WOAH-KAMRAN/AerialLab/rev4/hardware.md

# Rev 4 hardware list

All screws are M3 socket-head unless noted. Every screw into a printed part has a captive M3 hex nut in a hex pocket, so push the nut in before you fit the part. Lengths assume 1.0 mm sides, a 1.5 mm bottom, a 2 mm printed middle deck and a 1.0 mm upper deck.

## Airframe

| Where | Qty | Screw | Nut |
|---|---:|---|---|
| Side plates into nose frame, 4 frames and rear bulkhead (19 per side) | 38 | M3×10 | captive hex |
| Side plates into spar blocks (4 per side) | 8 | M3×12 | captive hex |
| Bottom plate up into nose frame, frames and bulkhead | 12 | M3×12 | captive hex |
| Middle deck (printed) down into the 4 frames | 8 | M3×12 | captive hex |
| Middle deck (printed) down into the nose frame | 2 | M3×10 | captive hex |
| Upper deck down into nose frame, frames and bulkhead | 12 | M3×10 | captive hex |
| Upper deck up into spar blocks | 4 | M3×10 | captive hex |
| Boom pins, through the upper deck and the boom (frame x = 296 and bulkhead) | 2 | M3×35 | captive hex |
| Joiner lock screws on top of the spar blocks (self-tap into PLA) | 2 | M3×8 | none |
| Battery tray to bottom plate | 4 | M3×10 countersunk | nyloc |
| Tail mount boom clamp | 2 | M3×20 | nyloc |
| H-stab to tail mount | 4 | M3×16 (nylon is fine) | nyloc |
| Motor to nose frame | 4 | M3×10, but check that it can't reach the windings | none |
| Camera mount to upper deck | 2 | M3×8 | nyloc |

## Landing gear (pick one)

| Option | Qty | Screw | Nut |
|---|---:|---|---|
| Trike: nose gear block to bottom plate | 4 | M3×12 | captive hex |
| Trike: nose leg lock screw (self-tap) | 1 | M3×20 | none |
| Trike or taildragger: main gear block to bottom plate | 4 | M3×12 | captive hex |
| Trike or taildragger: bow gear to main block | 2 | M3×12 | captive hex |

## Totals (with trike gear)

| Item | Qty |
|---|---:|
| M3×8 | 4 |
| M3×10 | 60 |
| M3×10 countersunk | 4 |
| M3×12 | 38 |
| M3×16 | 4 |
| M3×20 | 3 |
| M3×35 | 2 |
| **Screws total** | **115** |
| M3 hex nuts (captive) | 96 |
| M3 nyloc nuts | 12 |

For taildragger, drop 4 M3×12, 1 M3×20 and 4 hex nuts (the trike nose gear). Buy about 10% spares.

Flight electronics are not included above:
- FC: 4 M3, which self-tap into the printed standoffs.
- Pi Zero 2: 4 M2.5, which self-tap into its standoffs.
- VTX: 4 M2 or M3.
- GPS and antenna: M3 or zip ties.

## Tubes

| Item | Size | Length |
|---|---|---|
| Boom | 20 mm OD × 18 mm ID CF tube | 502 mm (cut from 1 m) |
| Front spar joiner | 8 mm OD × 6 mm ID CF tube | 400 mm |
| Rear spar joiner | 8 mm OD × 6 mm ID CF tube | 216 mm |
