WOAH-KAMRAN/AerialLab/rev4/sizing_report.md

# Sizing report (generated by sizing.py)

All x stations are mm aft of the side plate front edge. Estimates, so weigh the real parts.

## Wing

| item | value |
|---|---|
| span | 1200 mm |
| chord (rectangular) | 176 mm |
| area | 0.211 m² (21.1 dm²) |
| aspect ratio | 6.8 |
| airfoil | NACA 4412, 12% thick (21 mm) |
| incidence | 0.0° to the deck line |
| leading edge at root | x = 150 |
| front spar (25% chord) | x = 194, z = 100, 8 mm tube |
| rear spar (65% chord) | x = 264, z = 100, 8 mm tube |
| panel span each side | 567 mm (fuselage is 66 wide) |
| ailerons | outer 45% of each panel, 25% chord (44 mm) |

## Tail

| item | value |
|---|---|
| tail arm (wing AC to tail AC) | 480 mm |
| H-stab: Vh 0.45 | 348 cm², 360 x 97 mm, elevator 40 mm |
| fin: Vv 0.035 | 185 cm², root 155, tip 88, height 152, rudder 50 mm |
| H-stab leading edge | x = 650 |
| boom | 20x18 CF tube, x = 250 to 752 (502 mm long, cut from 1000) |
| boom held by | frame at x = 296 and rear bulkhead at x = 335 |

## Weight and balance

CG target: **x = 198 mm** (27% chord, 48 mm behind the wing leading edge). First flights anywhere from 25 to 30% (x = 194 to 203).

### Tractor

| item | g | x |
|---|---:|---:|
| Side plates x2 (CF 1.0) | 127 | 170 |
| Bottom plate (CF 1.5) | 52 | 170 |
| Upper deck (CF 1.0) | 29 | 170 |
| Middle deck, printed 2 mm, 2 halves | 31 | 170 |
| Printed nose frame, 4 frames, rear bulkhead, spar blocks | 145 | 191 |
| M3 hardware + nuts | 40 | 170 |
| Boom 20x18, 502 mm | 46 | 501 |
| Tail surfaces (6 mm Depron) + tail mount | 29 | 674 |
| Wing panels (foam, sleeves, 2 servos, covering) | 192 | 220 |
| Joiners: 8x6x400 + 8x6x216 | 21 | 220 |
| Elevator + rudder servos (9 g, middle bay) + pushrods | 33 | 150 |
| ESC 30-40 A (middle deck, nose) | 30 | 55 |
| Pi Zero 2 W + camera cable | 15 | 116 |
| Flight controller | 10 | 185 |
| Receiver | 6 | 215 |
| FPV camera + VTX + antenna | 30 | 50 |
| GPS | 15 | 105 |
| Nose cover (Depron/coro) | 20 | 45 |
| Wiring, connectors, velcro | 40 | 170 |
| Battery 3S 2200 mAh + tray | 195 | 242 |
| Motor 2826 1400 kv + prop adapter | 60 | -18 |
| Prop 8in | 12 | -45 |
| **AUW** | **1179** | CG 198 |

Battery centre for balance: **x = 242 mm** (a 105 mm pack spans 190 to 294). Fits in the lower bay. The battery tray station for this layout is x = 242; slide the pack on the tray to fine-tune.

## Performance (tractor AUW)

| item | value |
|---|---|
| wing loading | 55.8 g/dm² |
| stall speed (CLmax 1.0) | 9.5 m/s |
| stall speed (CLmax 1.2) | 8.6 m/s |
| cruise at CL 0.45 | 14.1 m/s (51 km/h) |
| Reynolds number at cruise | 165 k |
| cruise power, L/D 8, 45% propulsive eff. | 45 W, 4.1 A |
| flight time, 2200 mAh to 80% | about 26 min cruising |

## Motor + prop, static, 3S

Model: 2826 1400 kv, Rm 0.09 Ω, I0 1.2 A, 3S at 11.1 V under load. Ct/Cp are typical static values for APC-E style props.

| prop | rpm | thrust g | current A | power W | thrust/weight | pitch speed m/s |
|---|---:|---:|---:|---:|---:|---:|
| 8x4 | 12281 | 936 | 18.6 | 195 | 0.79 | 20.8 |
| 8x5 | 11828 | 910 | 21.2 | 220 | 0.77 | 25.0 |
| 8x6 | 11320 | 872 | 24.1 | 247 | 0.74 | 28.8 |
