WOAH-KAMRAN/AerialLab/rev4/stencils/plates_A4_stencil.pdf

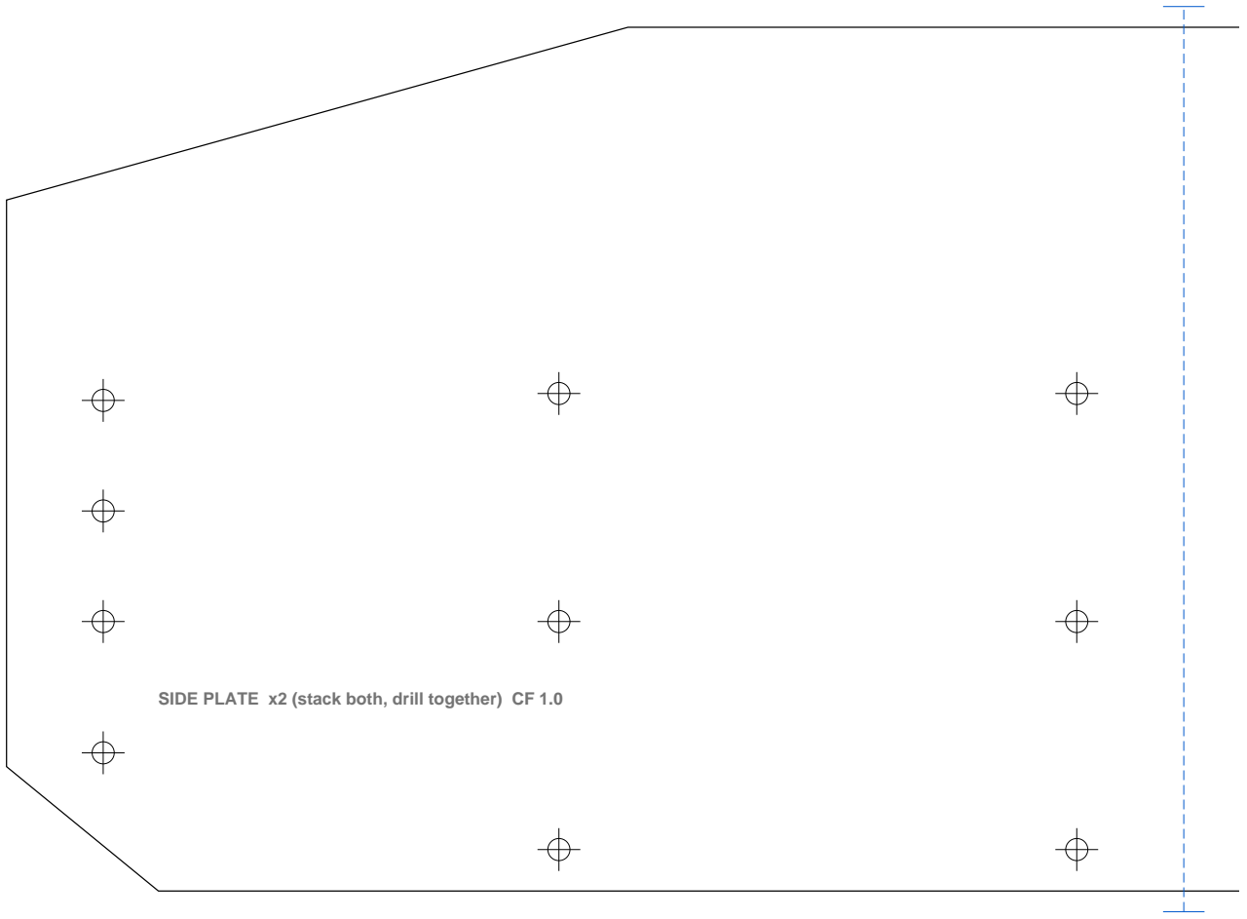
[picture p1: figure]

### SIDE PLATE x2 (stack both, drill together) CF 1.0

JOIN: trim page 1 here, lay it over page 2

## CF wing rev 4 (1.2 m) plate stencil, 1:1 page 1 of 4 (side_plate, front half)

Black circles M3 (3.2 mm), red circles spar holes. Centre-punch at each cross. Nose is on the left.

100 mm: measure this. If it is not exactly 100, reprint at 100 % / Actual size

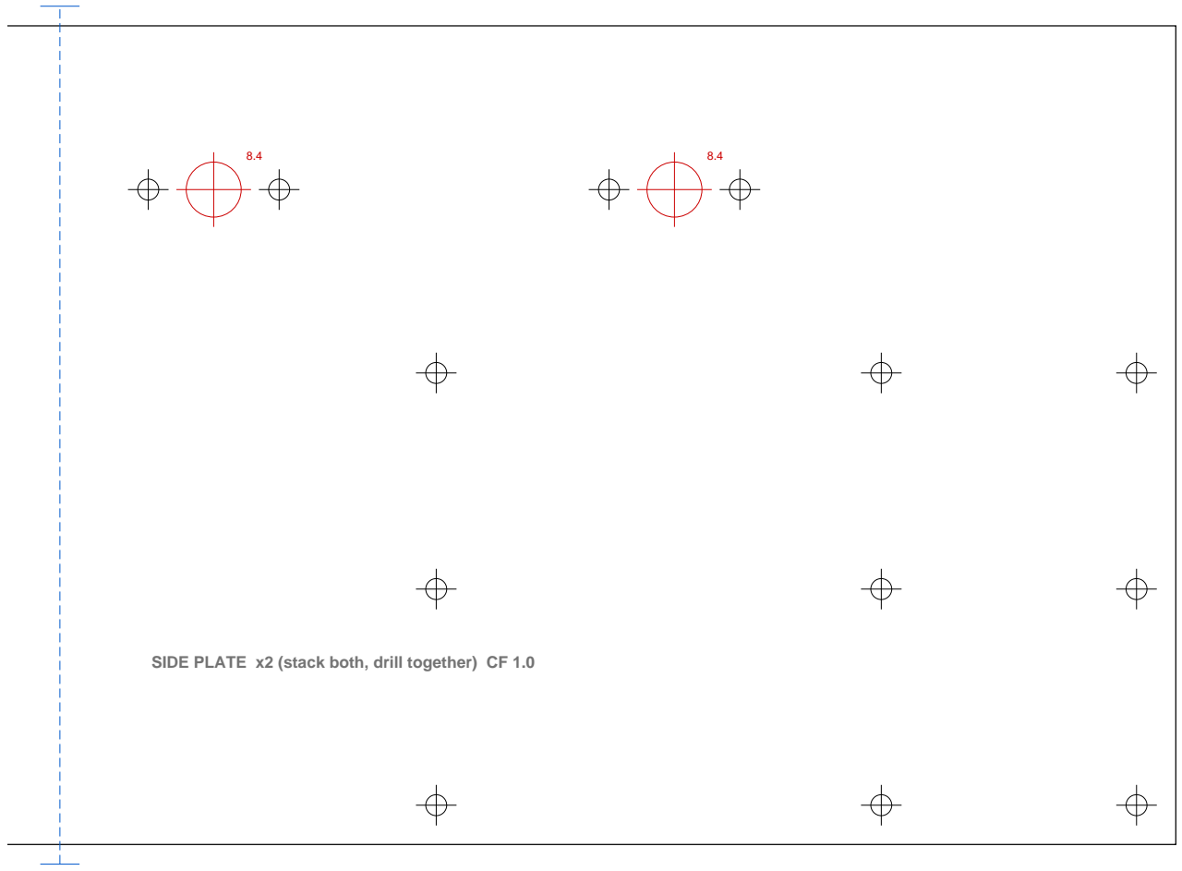
[picture p2: figure]

### SIDE PLATE x2 (stack both, drill together) CF 1.0

JOIN: trim page 1 here, lay it over page 2

## CF wing rev 4 (1.2 m) plate stencil, 1:1 page 2 of 4 (side_plate, rear half)

Black circles M3 (3.2 mm), red circles spar holes. Centre-punch at each cross. Nose is on the left, off this page.

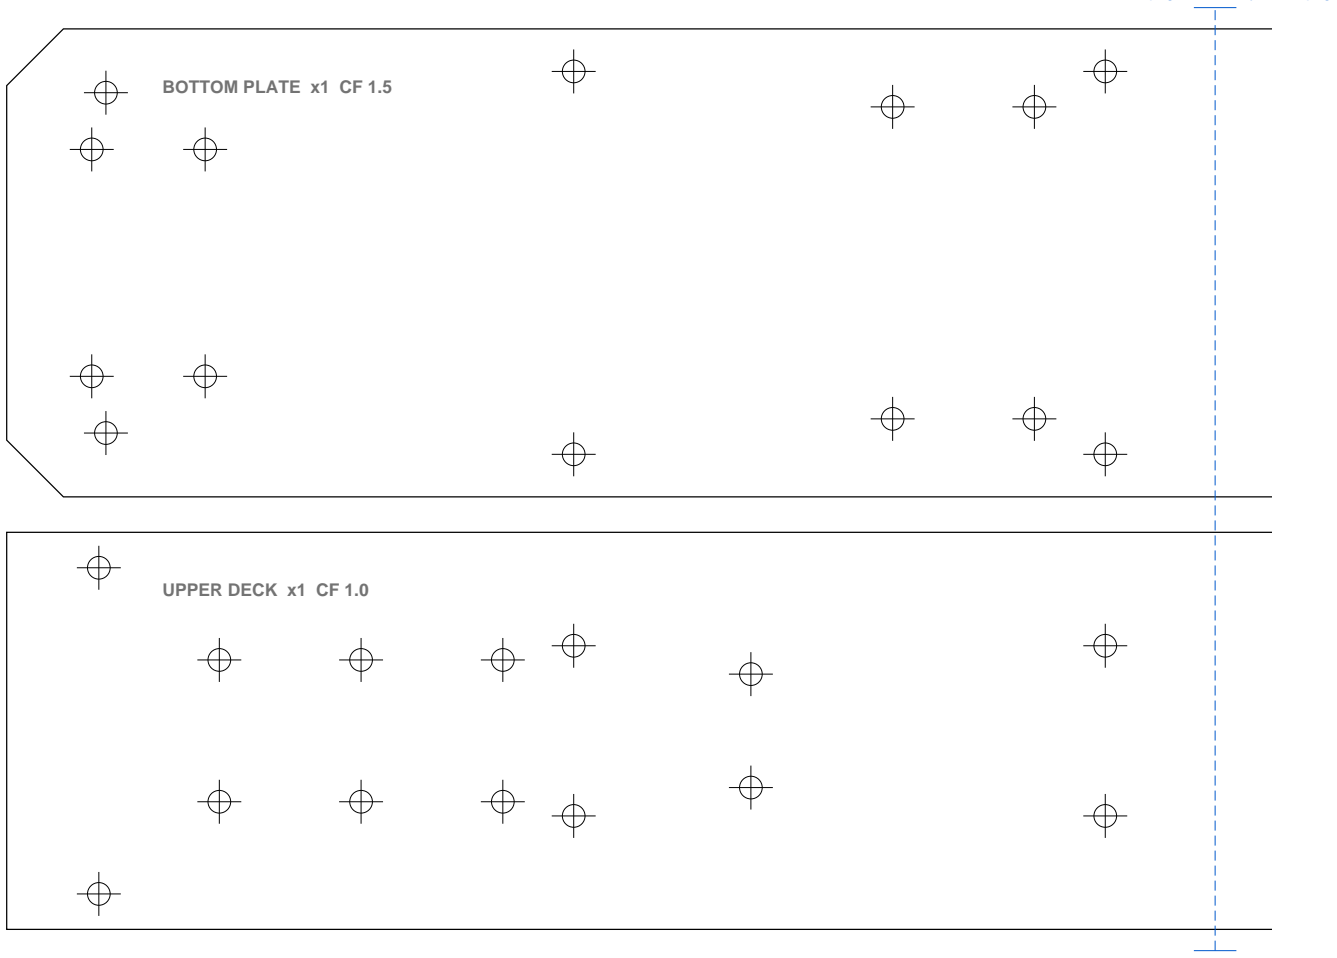
[picture p3: figure]
BOTTOM PLATE x1 CF 1.5; UPPER DECK x1 CF 1.0

JOIN: trim page 3 here, lay it over page 4

CF wing rev 4 (1.2 m) plate stencil, 1:1 page 3 of 4 (bottom_plate + upper_deck, front half)

Black circles M3 (3.2 mm), red circles spar holes. Centre-punch at each cross. Nose is on the left.

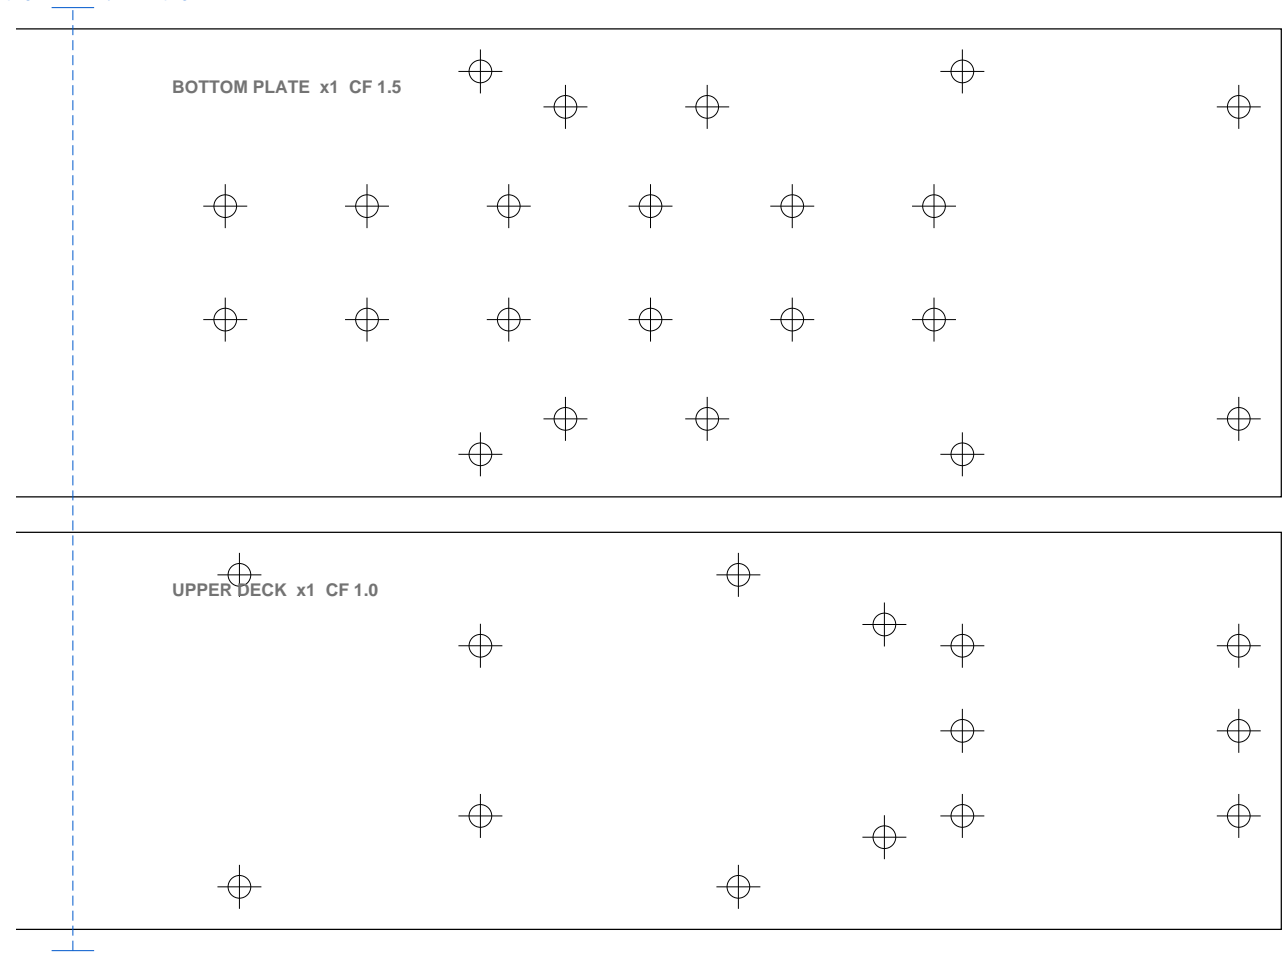
[picture p4: figure]
BOTTOM PLATE x1 CF 1.5; UPPER DECK x1 CF 1.0

JOIN: trim page 3 here, lay it over page 4

CF wing rev 4 (1.2 m) plate stencil, 1:1 page 4 of 4 (bottom_plate + upper_deck, rear half)

Black circles M3 (3.2 mm), red circles spar holes. Centre-punch at each cross. Nose is on the left, off this page.
