WOAH-KAMRAN/AerialLab/rev2/sizing_report.md

# Sizing report (generated by sizing.py)

All x stations are mm aft of the side plate front edge. Estimates, so weigh the real parts.

## Wing

| item | value |
|---|---|
| span | 1500 mm |
| chord (rectangular) | 220 mm |
| area | 0.330 m² (33.0 dm²) |
| aspect ratio | 6.8 |
| airfoil | Clark Y or similar flat-bottom section, ~11% thick (24 mm) |
| incidence | 2.0° to the deck line |
| leading edge at root | x = 180 |
| front spar (25% chord) | x = 235, z = 100, 10 mm tube |
| rear spar (65% chord) | x = 323, z = 97, 6 mm tube |
| panel span each side | 716 mm (fuselage is 67 wide) |
| ailerons | outer 45% of each panel, 25% chord (55 mm) |

## Tail

| item | value |
|---|---|
| tail arm (wing AC to tail AC) | 600 mm |
| H-stab: Vh 0.45 | 544 cm², 450 x 121 mm, elevator 40 mm |
| fin: Vv 0.035 | 289 cm², root 194, tip 110, height 190, rudder 50 mm |
| H-stab leading edge | x = 805 |
| boom | 16x14 CF tube, x = 300 to 931 (631 mm long, cut from 1000) |
| boom held by | frame at x = 330 and rear bulkhead at x = 409 |

## Weight and balance

CG target: **x = 239 mm** (27% chord, 59 mm behind the wing leading edge). First flights anywhere from 25 to 30% (x = 235 to 246).

### Tractor

| item | g | x |
|---|---:|---:|
| Side plates x2 (CF 1.5) | 234 | 208 |
| Bottom plate (CF 2.0) | 85 | 208 |
| Decks x2 (CF 1.0) | 71 | 208 |
| Printed nose frame, 4 frames, rear bulkhead, spar blocks | 160 | 232 |
| M3 hardware + nuts | 40 | 208 |
| Boom 16x14, 631 mm | 46 | 616 |
| Tail surfaces (6 mm Depron) + tail mount | 45 | 835 |
| Wing panels (foam, sleeves, 2 servos, covering) | 300 | 268 |
| Joiners: 10x8x500 + 6x4x270 | 28 | 268 |
| Elevator + rudder servos (9 g, middle bay) + pushrods | 33 | 150 |
| ESC 30-40 A (stays at the nose in both configs) | 30 | 70 |
| Flight controller | 10 | 210 |
| Receiver | 6 | 335 |
| FPV camera + VTX + antenna | 30 | 50 |
| GPS | 15 | 105 |
| Nose cover (Depron/coro) | 20 | 45 |
| Wiring, connectors, velcro | 40 | 208 |
| Battery 3S 2200 mAh + tray | 195 | 244 |
| Motor 2826 1400 kv + prop adapter | 60 | -18 |
| Prop 8in | 12 | -45 |
| **AUW** | **1460** | CG 239 |

Battery centre for balance: **x = 244 mm** (a 105 mm pack spans 192 to 296). Fits in the lower bay. The battery tray station for this layout is x = 240; slide the pack on the tray to fine-tune.

### Pusher

| item | g | x |
|---|---:|---:|
| Side plates x2 (CF 1.5) | 234 | 208 |
| Bottom plate (CF 2.0) | 85 | 208 |
| Decks x2 (CF 1.0) | 71 | 208 |
| Printed nose frame, 4 frames, rear bulkhead, spar blocks | 160 | 232 |
| M3 hardware + nuts | 40 | 208 |
| Boom 16x14, 631 mm | 46 | 616 |
| Tail surfaces (6 mm Depron) + tail mount | 45 | 835 |
| Wing panels (foam, sleeves, 2 servos, covering) | 300 | 268 |
| Joiners: 10x8x500 + 6x4x270 | 28 | 268 |
| Elevator + rudder servos (9 g, middle bay) + pushrods | 33 | 150 |
| ESC 30-40 A (stays at the nose in both configs) | 30 | 70 |
| Flight controller | 10 | 210 |
| Receiver | 6 | 335 |
| FPV camera + VTX + antenna | 30 | 50 |
| GPS | 15 | 105 |
| Nose cover (Depron/coro) | 20 | 45 |
| Wiring, connectors, velcro | 40 | 208 |
| Battery 3S 2200 mAh + tray | 195 | 61 |
| Motor 2826 1400 kv + prop adapter | 60 | 437 |
| Prop 8in | 12 | 460 |
| Pusher mount | 14 | 395 |
| **AUW** | **1474** | CG 239 |

Battery centre for balance: **x = 61 mm** (a 105 mm pack spans 9 to 113). Fits in the lower bay. The battery tray station for this layout is x = 60; slide the pack on the tray to fine-tune.

## Performance (tractor AUW)

| item | value |
|---|---|
| wing loading | 44.2 g/dm² |
| stall speed (CLmax 1.0) | 8.4 m/s |
| stall speed (CLmax 1.2) | 7.7 m/s |
| cruise at CL 0.45 | 12.5 m/s (45 km/h) |
| Reynolds number at cruise | 184 k |
| cruise power, L/D 8, 45% propulsive eff. | 50 W, 4.5 A |
| flight time, 2200 mAh to 80% | about 23 min cruising |

## Motor + prop, static, 3S

Model: 2826 1400 kv, Rm 0.09 Ω, I0 1.2 A, 3S at 11.1 V under load. Ct/Cp are typical static values for APC-E style props.

| prop | rpm | thrust g | current A | power W | thrust/weight | pitch speed m/s |
|---|---:|---:|---:|---:|---:|---:|
| 8x4 | 12281 | 936 | 18.6 | 195 | 0.64 | 20.8 |
| 8x5 | 11828 | 910 | 21.2 | 220 | 0.62 | 25.0 |
| 8x6 | 11320 | 872 | 24.1 | 247 | 0.60 | 28.8 |
