WOAH-KAMRAN/AerialLab/rev4/png/a_full_tractor.png

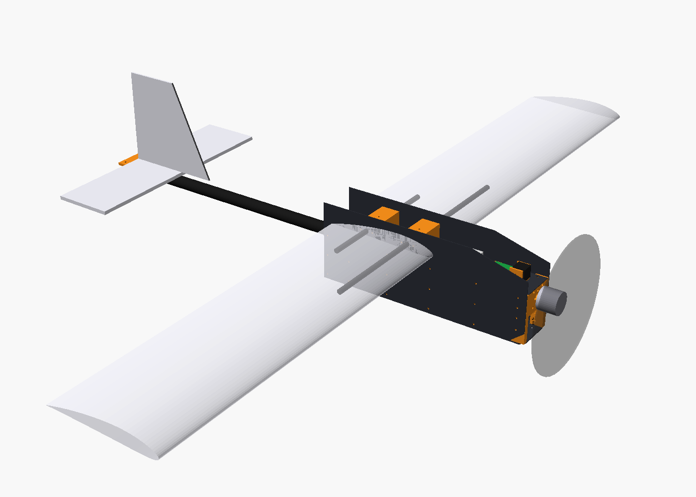
rev4/png/a_full_tractor.png
