WOAH-KAMRAN/AerialLab/rev4/png/b_fuselage_tractor.png

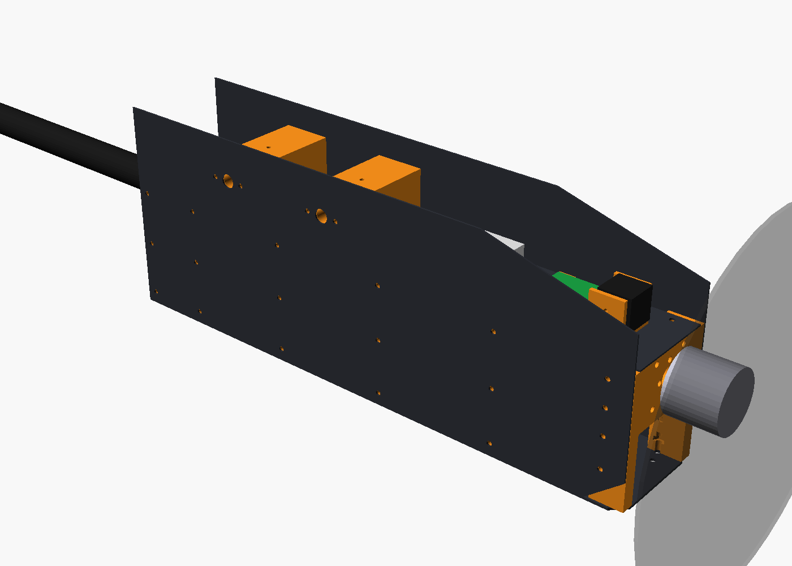
rev4/png/b_fuselage_tractor.png
