WOAH-KAMRAN/AerialLab/rev4/png/c_fuselage_cutaway.png

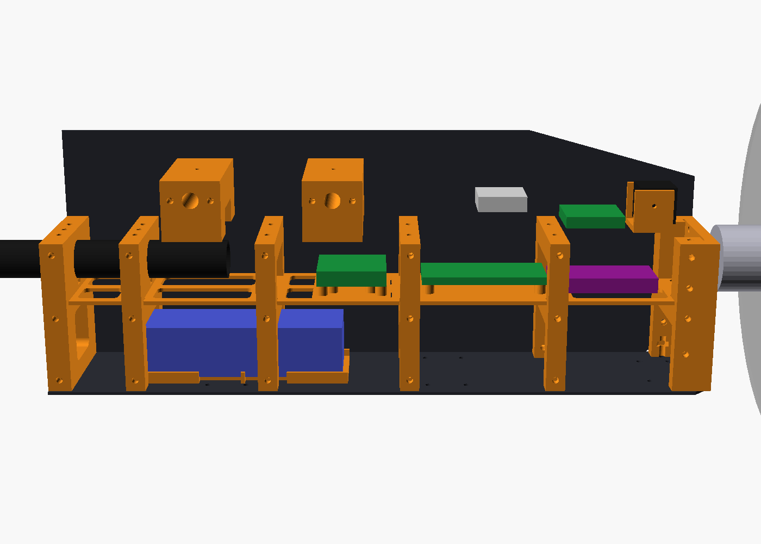
rev4/png/c_fuselage_cutaway.png
