WOAH-KAMRAN/AerialLab/rev4/png/d_fuselage_rear.png

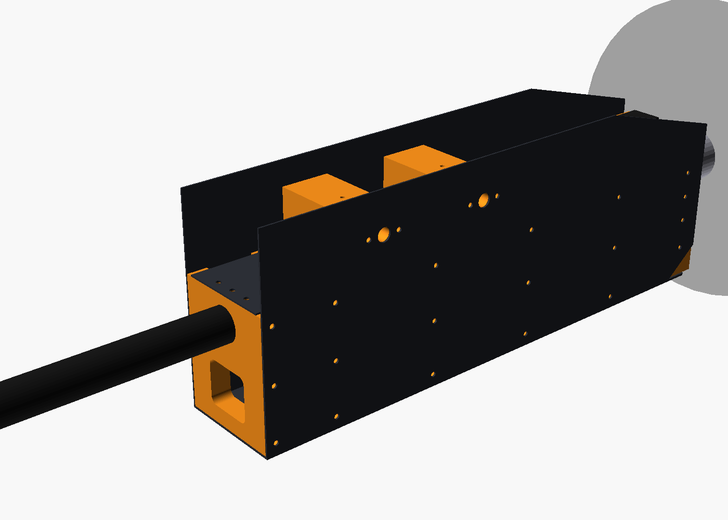
rev4/png/d_fuselage_rear.png
