WOAH-KAMRAN/AerialLab/rev4/png/e_side.png

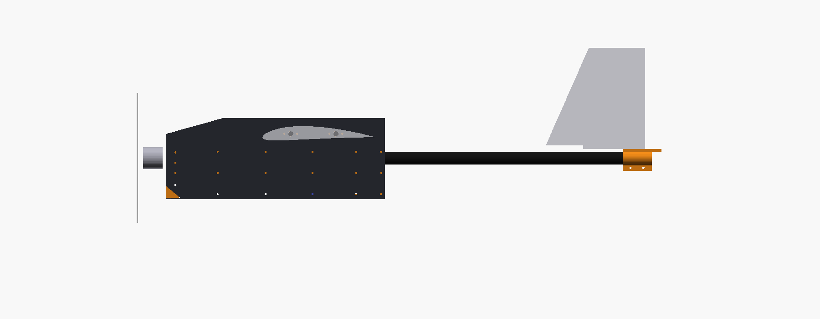
rev4/png/e_side.png
