WOAH-KAMRAN/AerialLab/rev4/cad/assembly.step

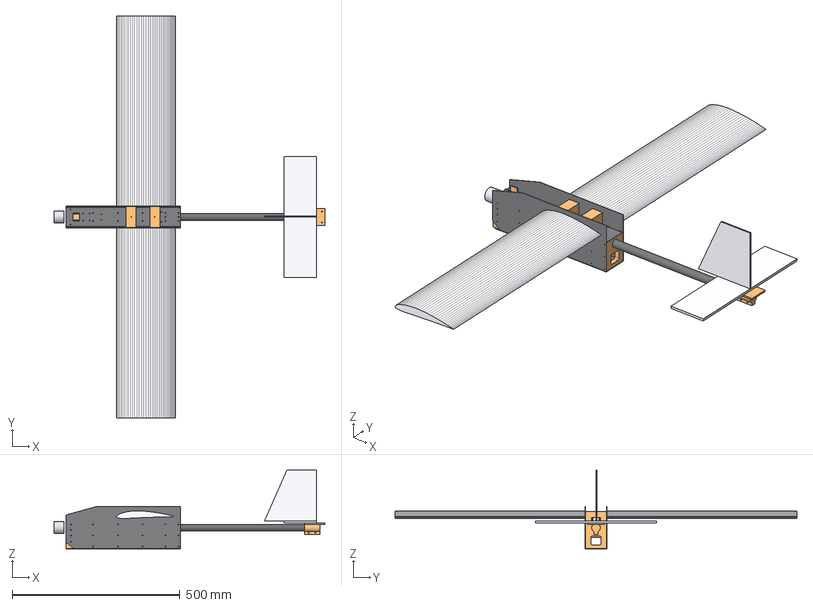
[picture p13: CAD file, 2026-10-10]
rev4/cad/assembly.step
808.0 x 1200.0 x 235.5 mm
cf_side_left
cf_side_right
cf_bottom
cf_up_deck
nose_frame
frame_80
frame_155
frame_228
frame_296
rear_bulkhead
middle_deck_front
middle_deck_rear
spar_block_front
spar_block_rear
battery_tray
camera_mount
tail_mount
boom_20x18
joiner_front_8x6
joiner_rear_8x6
wing_left
wing_right
h_stab
fin
motor_2826
