WOAH-KAMRAN/AerialLab/rev4/cad/step/printed/gear_block_main_optional.step

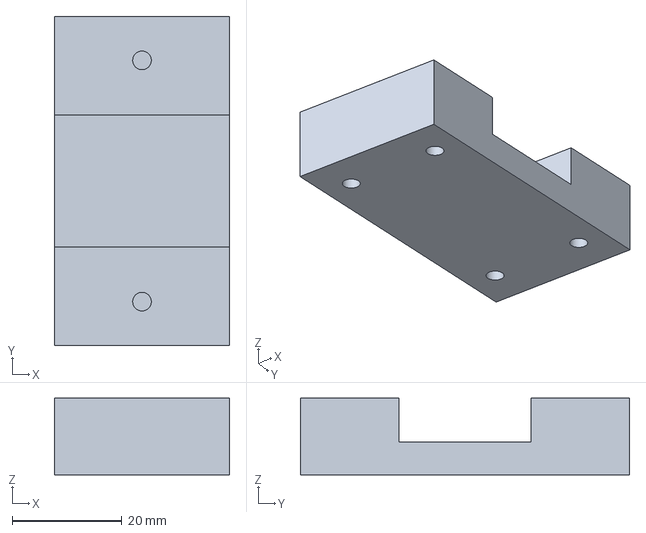
[picture p14: CAD file, 2026-10-10]
rev4/cad/step/printed/gear_block_main_optional.step
32.0 x 60.0 x 14.0 mm
