WOAH-KAMRAN/AerialLab/rev4/cad/dxf/upper_deck.dxf

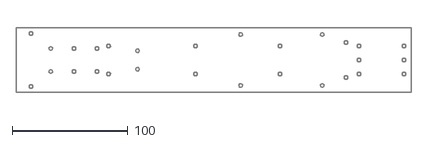
[picture p15: CAD file, 2026-10-10]
rev4/cad/dxf/upper_deck.dxf
341.0 x 56.0
