WOAH-KAMRAN/AerialLab/rev4/cad/step/cf_plates/bottom_plate.step

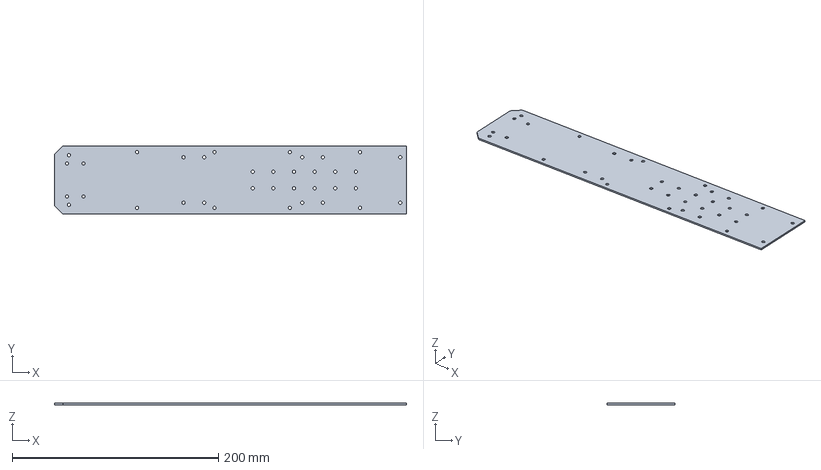
[picture p16: CAD file, 2026-10-10]
rev4/cad/step/cf_plates/bottom_plate.step
341.0 x 66.0 x 1.50 mm
