WOAH-KAMRAN/AerialLab/rev4/cad/step/printed/frame_x3.step

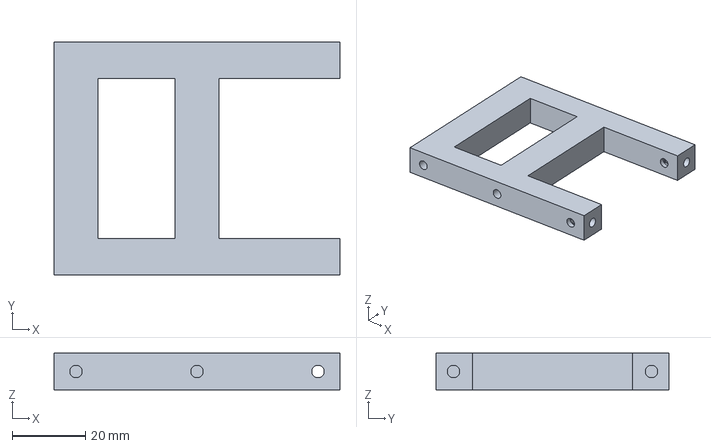
[picture p17: CAD file, 2026-10-10]
rev4/cad/step/printed/frame_x3.step
78.0 x 63.6 x 10.0 mm
