WOAH-KAMRAN/AerialLab/rev4/cad/dxf/bottom_plate.dxf

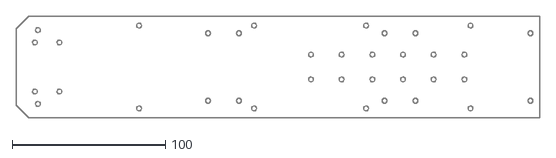
[picture p18: CAD file, 2026-10-10]
rev4/cad/dxf/bottom_plate.dxf
341.0 x 66.0
