WOAH-KAMRAN/AerialLab/rev4/cad/step/cf_plates/side_plate.step

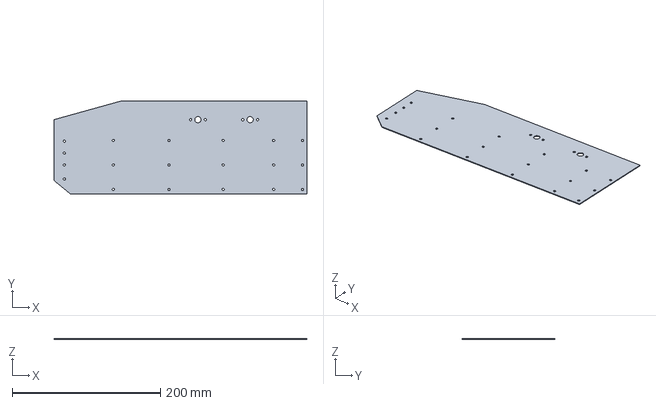
[picture p19: CAD file, 2026-10-10]
rev4/cad/step/cf_plates/side_plate.step
341.0 x 125.0 x 1.00 mm
