WOAH-KAMRAN/AerialLab/rev4/cad/step/printed/camera_mount.step

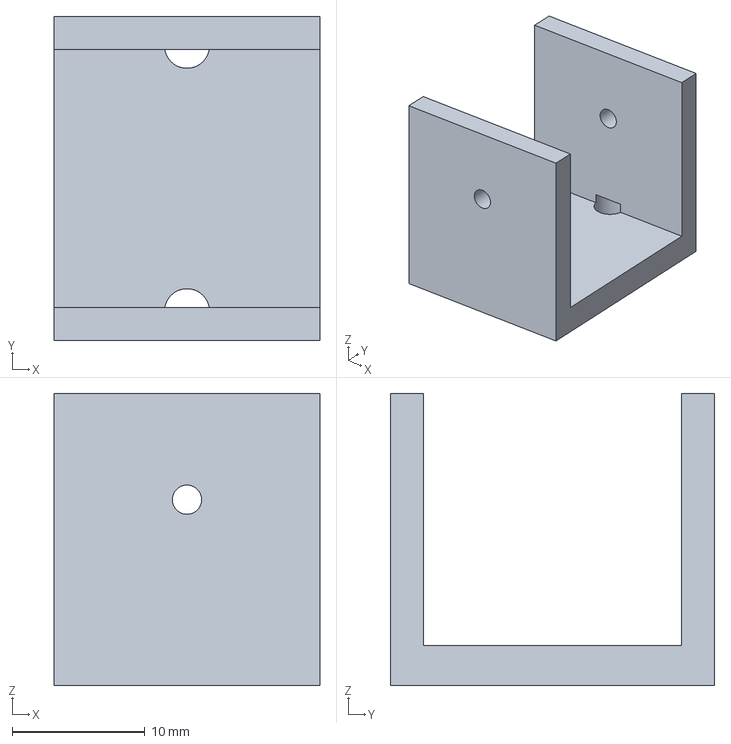
[picture p20: CAD file, 2026-10-10]
rev4/cad/step/printed/camera_mount.step
20.0 x 24.4 x 22.0 mm
