WOAH-KAMRAN/AerialLab/rev4/cad/dxf/side_plate.dxf

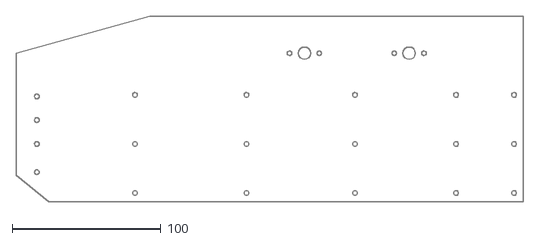
[picture p21: CAD file, 2026-10-10]
rev4/cad/dxf/side_plate.dxf
341.0 x 125.0
