WOAH-KAMRAN/AerialLab/rev4/cad/step/cf_plates/upper_deck.step

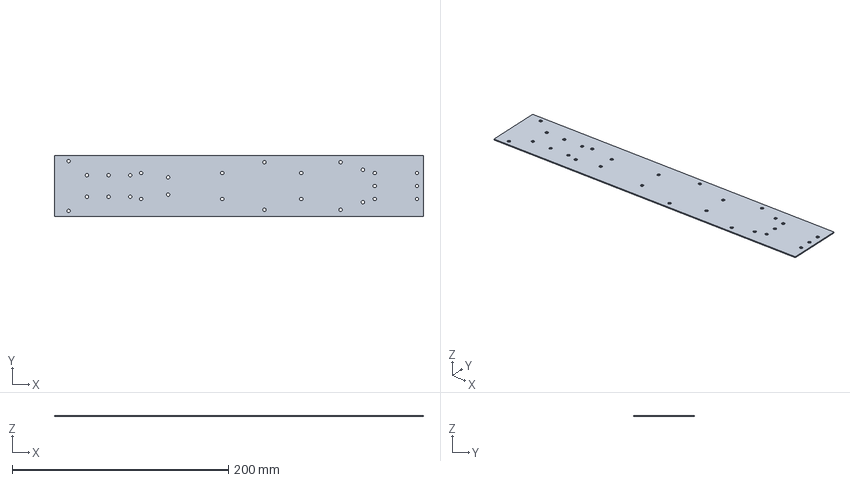
[picture p22: CAD file, 2026-10-10]
rev4/cad/step/cf_plates/upper_deck.step
341.0 x 56.0 x 1.00 mm
