WOAH-KAMRAN/AerialLab/rev4/cad/step/printed/rear_bulkhead.step

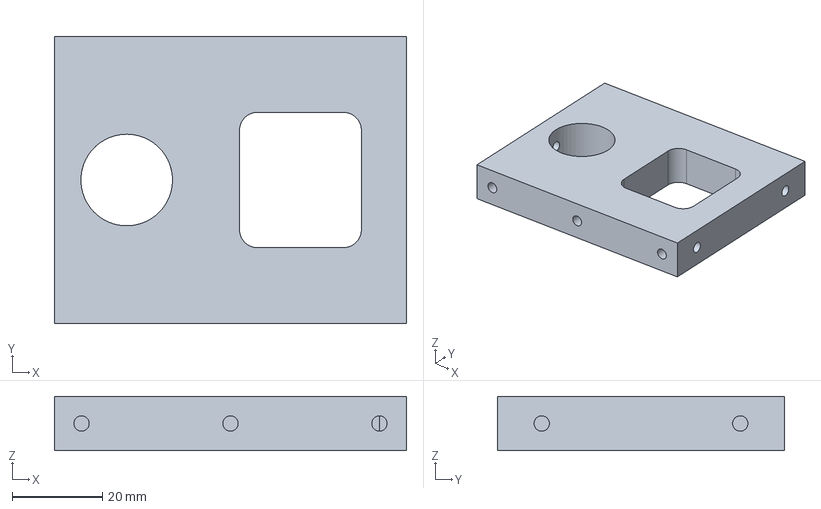
[picture p23: CAD file, 2026-10-10]
rev4/cad/step/printed/rear_bulkhead.step
78.0 x 63.6 x 12.0 mm
