WOAH-KAMRAN/AerialLab/rev4/cad/step/printed/tail_mount.step

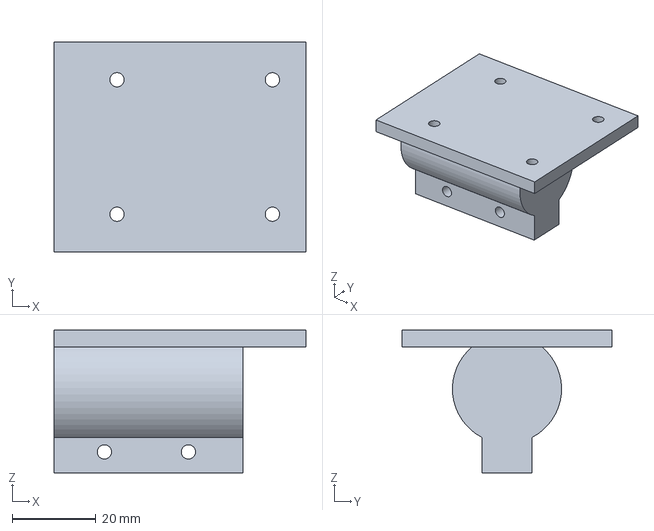
[picture p24: CAD file, 2026-10-10]
rev4/cad/step/printed/tail_mount.step
60.0 x 50.0 x 34.0 mm
