WOAH-KAMRAN/AerialLab/rev4/cad/step/printed/spar_block_rear.step

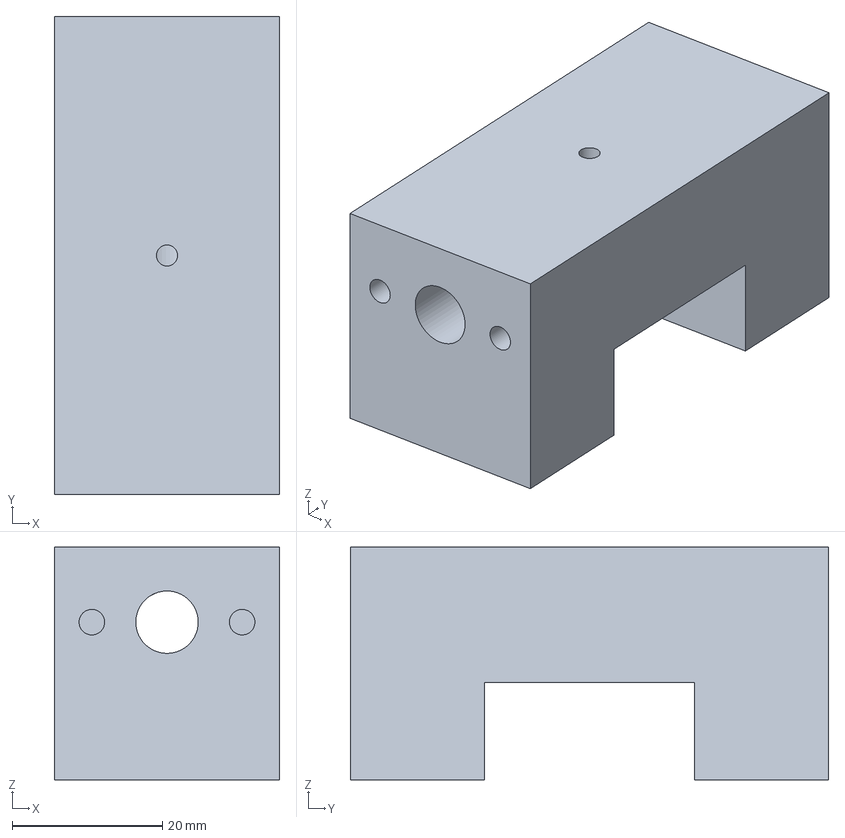
[picture p25: CAD file, 2026-10-10]
rev4/cad/step/printed/spar_block_rear.step
30.0 x 63.6 x 31.0 mm
