WOAH-KAMRAN/AerialLab/rev4/cad/step/printed/nose_frame_firewall.step

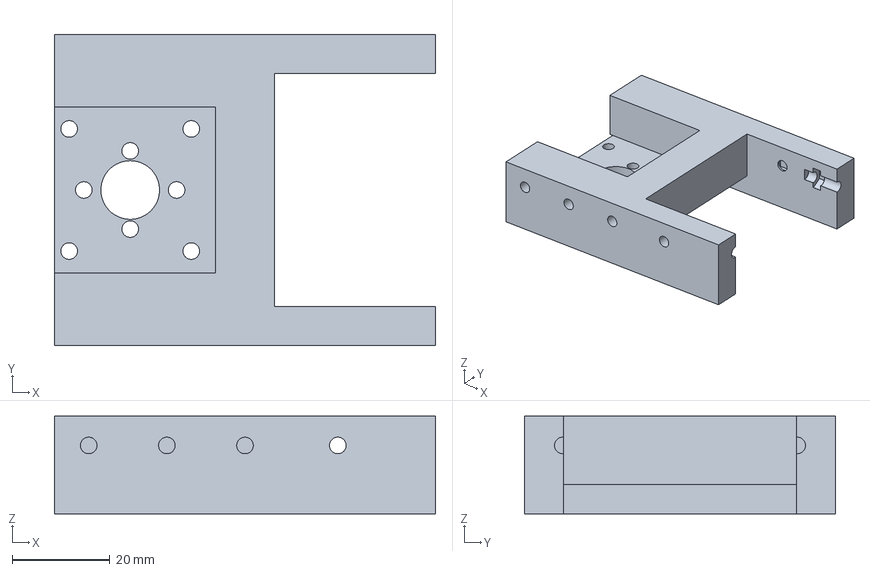
[picture p26: CAD file, 2026-10-10]
rev4/cad/step/printed/nose_frame_firewall.step
78.0 x 63.6 x 20.0 mm
