WOAH-KAMRAN/AerialLab/rev4/cad/step/printed/battery_tray.step

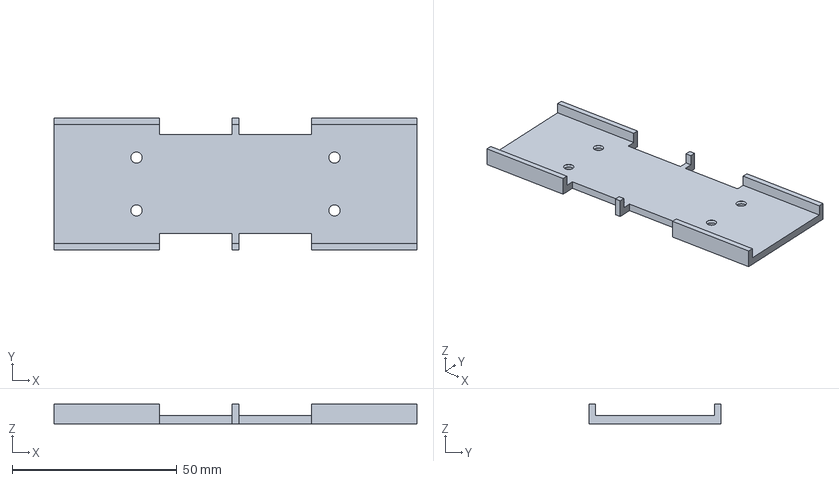
[picture p27: CAD file, 2026-10-10]
rev4/cad/step/printed/battery_tray.step
110.0 x 40.0 x 6.00 mm
