WOAH-KAMRAN/AerialLab/rev4/cad/step/printed/frame_boom.step

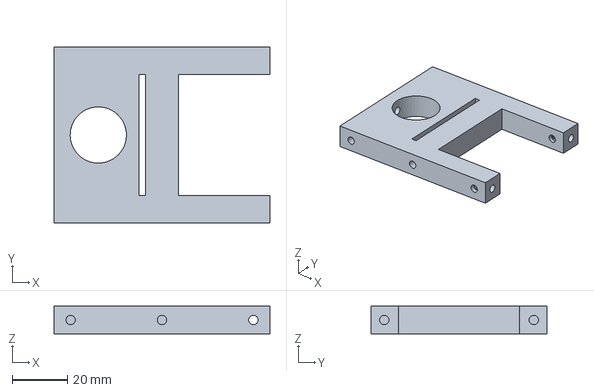
[picture p28: CAD file, 2026-10-10]
rev4/cad/step/printed/frame_boom.step
78.0 x 63.6 x 10.00 mm
