WOAH-KAMRAN/AerialLab/rev4/cad/step/printed/middle_deck_front.step

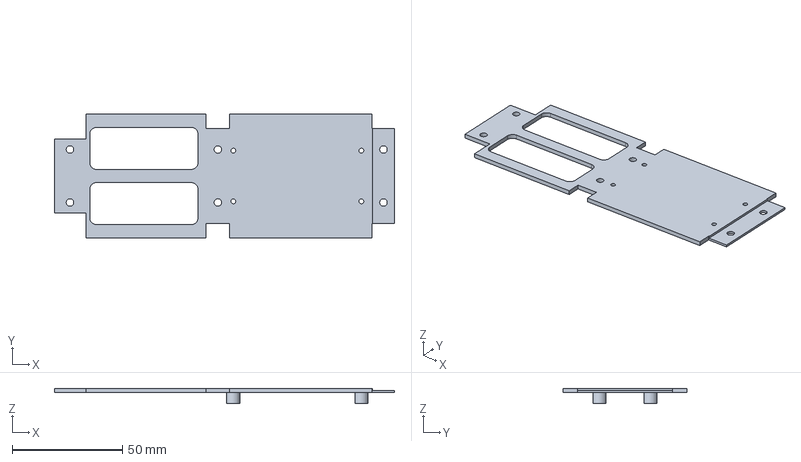
[picture p29: CAD file, 2026-10-10]
rev4/cad/step/printed/middle_deck_front.step
154.0 x 56.0 x 7.00 mm
