WOAH-KAMRAN/AerialLab/rev4/cad/step/printed/middle_deck_rear.step

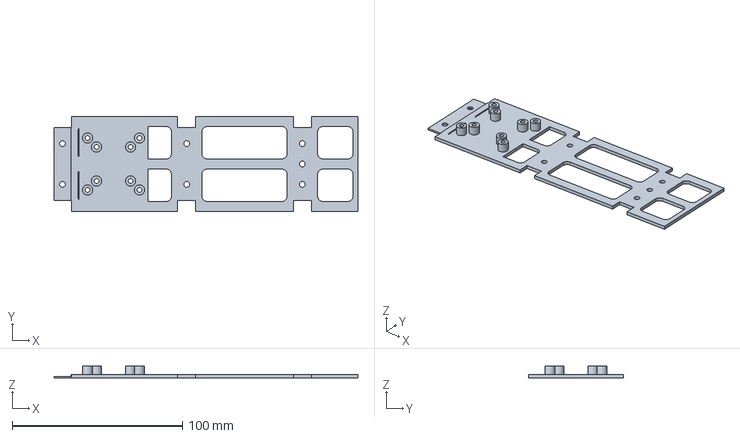
[picture p30: CAD file, 2026-10-10]
rev4/cad/step/printed/middle_deck_rear.step
178.7 x 56.0 x 7.00 mm
