WOAH-KAMRAN/AerialLab/rev4/cad/step/printed/gear_block_nose_optional.step

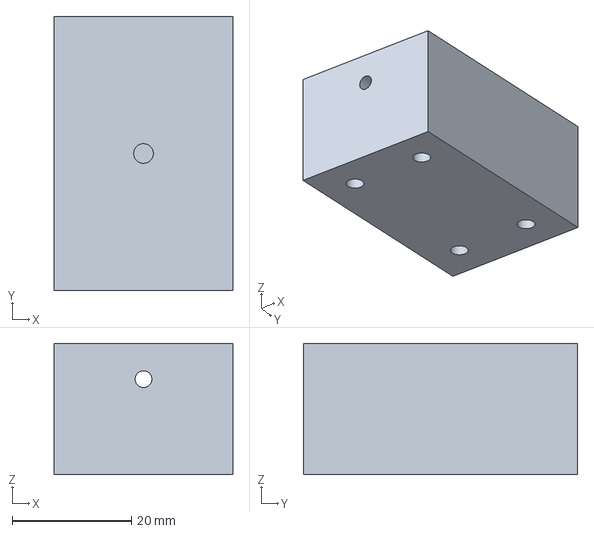
[picture p31: CAD file, 2026-10-10]
rev4/cad/step/printed/gear_block_nose_optional.step
30.0 x 46.0 x 22.0 mm
