WOAH-KAMRAN/AerialLab/(list of files, cad)

Other CAD files:
rev4/cad/step/printed/spar_block_front.step
rev2/cad/assembly.step
rev2/cad/assembly.stl
rev2/cad/assembly_pusher.step
rev2/cad/assembly_pusher.stl
rev2/cad/dxf/bottom_plate.dxf
rev2/cad/dxf/middle_deck.dxf
rev2/cad/dxf/side_plate.dxf
rev2/cad/dxf/upper_deck.dxf
rev2/cad/step/cf_plates/bottom_plate.step
rev2/cad/step/cf_plates/middle_deck.step
rev2/cad/step/cf_plates/side_plate.step
rev2/cad/step/cf_plates/upper_deck.step
rev2/cad/step/printed/battery_tray.step
rev2/cad/step/printed/camera_mount.step
rev2/cad/step/printed/frame_boom.step
rev2/cad/step/printed/frame_x3.step
rev2/cad/step/printed/gear_block_main_optional.step
rev2/cad/step/printed/gear_block_nose_optional.step
rev2/cad/step/printed/nose_frame_firewall.step
rev2/cad/step/printed/pusher_mount_optional.step
rev2/cad/step/printed/rear_bulkhead.step
rev2/cad/step/printed/spar_block_front.step
rev2/cad/step/printed/spar_block_rear.step
rev2/cad/step/printed/tail_mount.step
rev2/cad/stl/cf_plates/bottom_plate.stl
rev2/cad/stl/cf_plates/middle_deck.stl
rev2/cad/stl/cf_plates/side_plate.stl
rev2/cad/stl/cf_plates/upper_deck.stl
rev2/cad/stl/printed/battery_tray.stl
rev2/cad/stl/printed/camera_mount.stl
rev2/cad/stl/printed/frame_boom.stl
rev2/cad/stl/printed/frame_x3.stl
rev2/cad/stl/printed/gear_block_main_optional.stl
rev2/cad/stl/printed/gear_block_nose_optional.stl
rev2/cad/stl/printed/nose_frame_firewall.stl
rev2/cad/stl/printed/pusher_mount_optional.stl
rev2/cad/stl/printed/rear_bulkhead.stl
rev2/cad/stl/printed/spar_block_front.stl
rev2/cad/stl/printed/spar_block_rear.stl
rev2/cad/stl/printed/tail_mount.stl
rev3/cad/assembly.step
rev3/cad/assembly.stl
rev3/cad/assembly_pusher.step
rev3/cad/assembly_pusher.stl
rev3/cad/dxf/bottom_plate.dxf
rev3/cad/dxf/side_plate.dxf
rev3/cad/dxf/upper_deck.dxf
rev3/cad/step/cf_plates/bottom_plate.step
rev3/cad/step/cf_plates/side_plate.step
rev3/cad/step/cf_plates/upper_deck.step
rev3/cad/step/printed/battery_tray.step
rev3/cad/step/printed/camera_mount.step
rev3/cad/step/printed/frame_boom.step
rev3/cad/step/printed/frame_x3.step
rev3/cad/step/printed/gear_block_main_optional.step
rev3/cad/step/printed/gear_block_nose_optional.step
rev3/cad/step/printed/middle_deck_front.step
rev3/cad/step/printed/middle_deck_rear.step
rev3/cad/step/printed/nose_frame_firewall.step
rev3/cad/step/printed/pusher_mount_optional.step
rev3/cad/step/printed/rear_bulkhead.step
rev3/cad/step/printed/spar_block_front.step
rev3/cad/step/printed/spar_block_rear.step
rev3/cad/step/printed/tail_mount.step
rev3/cad/stl/cf_plates/bottom_plate.stl
rev3/cad/stl/cf_plates/side_plate.stl
rev3/cad/stl/cf_plates/upper_deck.stl
rev3/cad/stl/printed/battery_tray.stl
rev3/cad/stl/printed/camera_mount.stl
rev3/cad/stl/printed/frame_boom.stl
rev3/cad/stl/printed/frame_x3.stl
rev3/cad/stl/printed/gear_block_main_optional.stl
rev3/cad/stl/printed/gear_block_nose_optional.stl
rev3/cad/stl/printed/middle_deck_front.stl
rev3/cad/stl/printed/middle_deck_rear.stl
rev3/cad/stl/printed/nose_frame_firewall.stl
rev3/cad/stl/printed/pusher_mount_optional.stl
rev3/cad/stl/printed/rear_bulkhead.stl
rev3/cad/stl/printed/spar_block_front.stl
rev3/cad/stl/printed/spar_block_rear.stl
rev3/cad/stl/printed/tail_mount.stl
rev4/cad/assembly.stl
rev4/cad/stl/cf_plates/bottom_plate.stl
rev4/cad/stl/cf_plates/side_plate.stl
rev4/cad/stl/cf_plates/upper_deck.stl
rev4/cad/stl/printed/battery_tray.stl
rev4/cad/stl/printed/camera_mount.stl
rev4/cad/stl/printed/frame_boom.stl
rev4/cad/stl/printed/frame_x3.stl
rev4/cad/stl/printed/gear_block_main_optional.stl
rev4/cad/stl/printed/gear_block_nose_optional.stl
rev4/cad/stl/printed/middle_deck_front.stl
rev4/cad/stl/printed/middle_deck_rear.stl
rev4/cad/stl/printed/nose_frame_firewall.stl
rev4/cad/stl/printed/rear_bulkhead.stl
rev4/cad/stl/printed/spar_block_front.stl
rev4/cad/stl/printed/spar_block_rear.stl
rev4/cad/stl/printed/tail_mount.stl
